RP-Coders/ArduinoWorkshop-LED-Driver/README.md

# ArduinoWorkshop-LED-Driver
Course 1 - LED Driver

This project is originally used for a course.
