RP-Coders/ArduinoWorkshop-LED-Driver/Code/Arduino workshop/README.md

# Files

Workshop 1 is the beginners example for arduino coding.

Workshop 2 is the a little more advanced

Workshop 3 is the full code for running the LED Driver - make note of the remote control values if you use something else but the Eizo remote.
