RP-Coders/ArduinoWorkshop-LED-Driver/Hardware/Eagle/5channel-LED-Relay.brd

## EAGLE design Hardware/Eagle/5channel-LED-Relay.brd (2018-10-08)

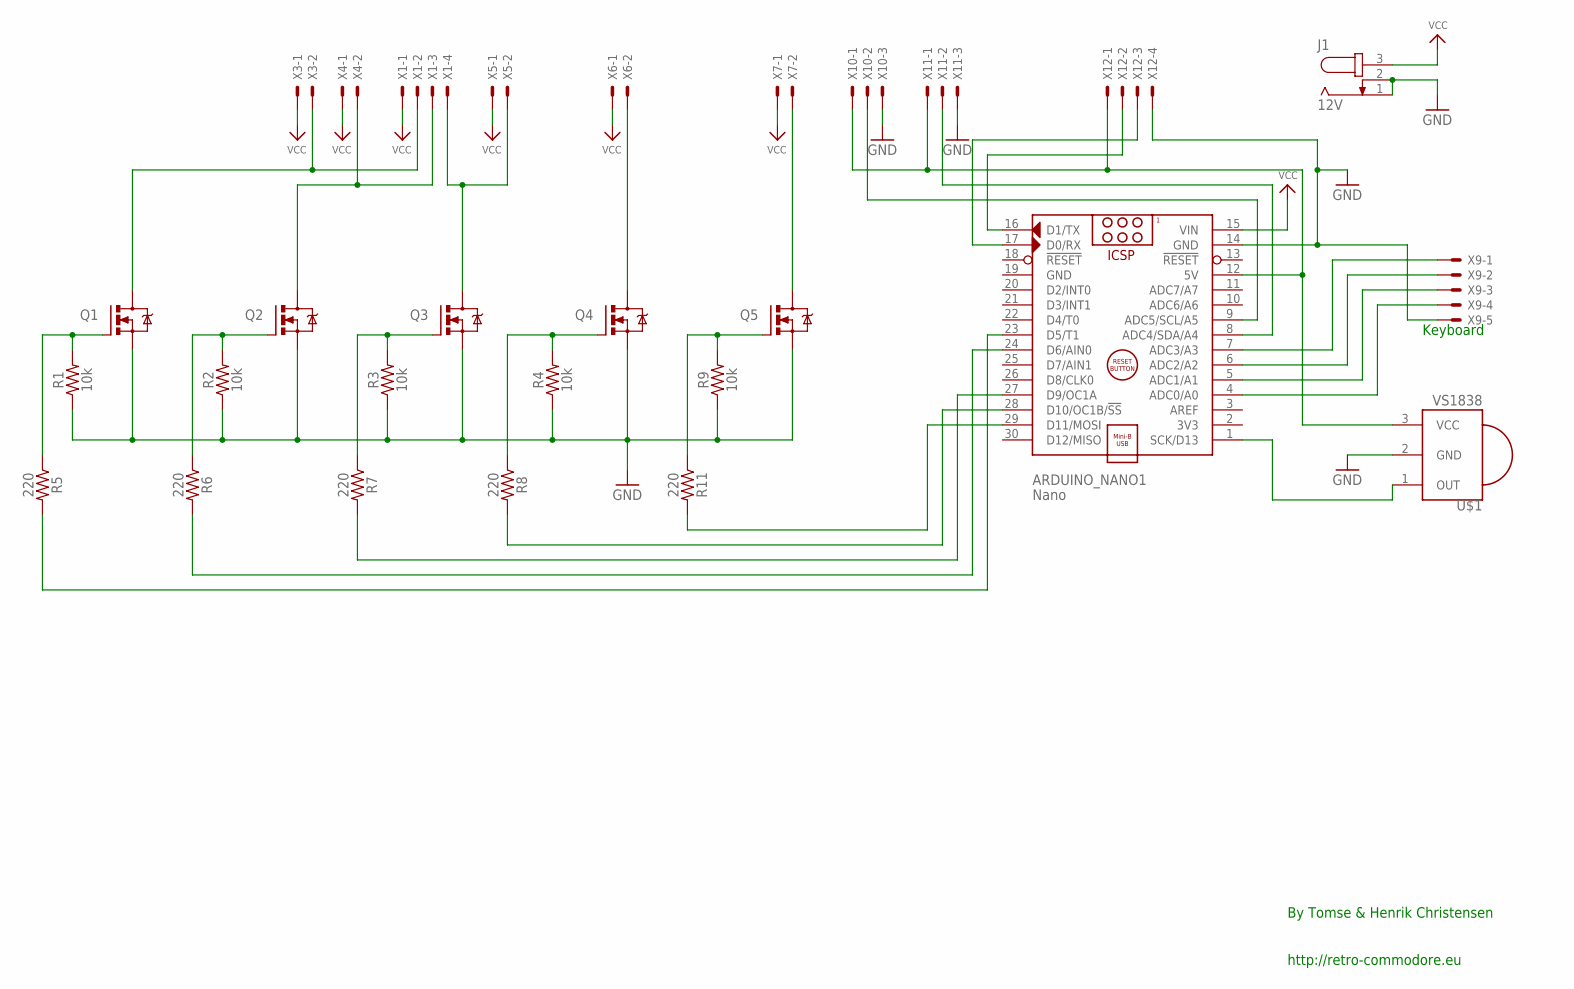
[picture p5: schematic 5channel-LED-Relay.sch]

Parts:
ARDUINO_NANO1: Nano; ARDUINO_NANO
J1: 12V; SPC4077
Q1, Q2, Q3, Q4, Q5: FQP30N06L; TO220BV
R1, R2, R3, R4, R9: 10k; AXIAL-0.3
R5, R6, R7, R8, R11: 220; AXIAL-0.3
U$1: VS1838; PNA460XM
X1, X12: JST-XH-04-PIN-LONG-PAD; JST-XH-04-PACKAGE-LONG-PAD
X3, X4, X5, X6, X7: JST-XH-02-PIN-LONG-PAD; JST-XH-02-PACKAGE-LONG-PAD
X9: JST-XH-05-PIN-LONG-PAD; JST-XH-05-PACKAGE-LONG-PAD
X10, X11: JST-XH-03-PIN-LONG-PAD; JST-XH-03-PACKAGE-LONG-PAD

Connections:
5V: ARDUINO_NANO1.12 (5V), U$1.3 (VCC), X10.1, X11.1, X12.1
C01: Q1.D, X1.2, X3.2
C02: Q2.D, X1.3, X4.2
C03: Q3.D, X1.4, X5.2
C04: Q4.D, X6.2
C05: Q5.D, X7.2
GND: ARDUINO_NANO1.14 (GND), ARDUINO_NANO1.19 (GND), J1.1, J1.2, Q1.S, Q2.S, Q3.S, Q4.S, Q5.S, R1.P$1 (1), R2.P$1 (1), R3.P$1 (1), R4.P$1 (1), R9.P$1 (1), U$1.2 (GND), X9.5, X10.3, X11.3, X12.4
unnamed: ARDUINO_NANO1.8 (ADC4/SDA/A4), X11.2
unnamed: ARDUINO_NANO1.9 (ADC5/SCL/A5), X10.2
unnamed: ARDUINO_NANO1.29 (D11/MOSI), R11.P$2 (2)
unnamed: ARDUINO_NANO1.1 (SCK/D13), U$1.1 (OUT)
unnamed: Q4.G, R4.P$2 (2), R8.P$1 (1)
unnamed: ARDUINO_NANO1.23 (D5/T1), R5.P$2 (2)
unnamed: ARDUINO_NANO1.24 (D6/AIN0), R6.P$2 (2)
unnamed: ARDUINO_NANO1.27 (D9/OC1A), R7.P$2 (2)
unnamed: ARDUINO_NANO1.28 (D10/OC1B/!SS), R8.P$2 (2)
unnamed: ARDUINO_NANO1.16 (D1/TX), X12.2
unnamed: Q2.G, R2.P$2 (2), R6.P$1 (1)
unnamed: ARDUINO_NANO1.17 (D0/RX), X12.3
unnamed: ARDUINO_NANO1.7 (ADC3/A3), X9.1
unnamed: Q5.G, R9.P$2 (2), R11.P$1 (1)
unnamed: ARDUINO_NANO1.6 (ADC2/A2), X9.2
unnamed: Q3.G, R3.P$2 (2), R7.P$1 (1)
unnamed: ARDUINO_NANO1.5 (ADC1/A1), X9.3
unnamed: ARDUINO_NANO1.4 (ADC0/A0), X9.4
unnamed: Q1.G, R1.P$2 (2), R5.P$1 (1)
VCC: ARDUINO_NANO1.15 (VIN), J1.3, X1.1, X3.1, X4.1, X5.1, X6.1, X7.1

Notes on the sheet:
Keyboard
By Tomse & Henrik Christensen http://retro-commodore.eu

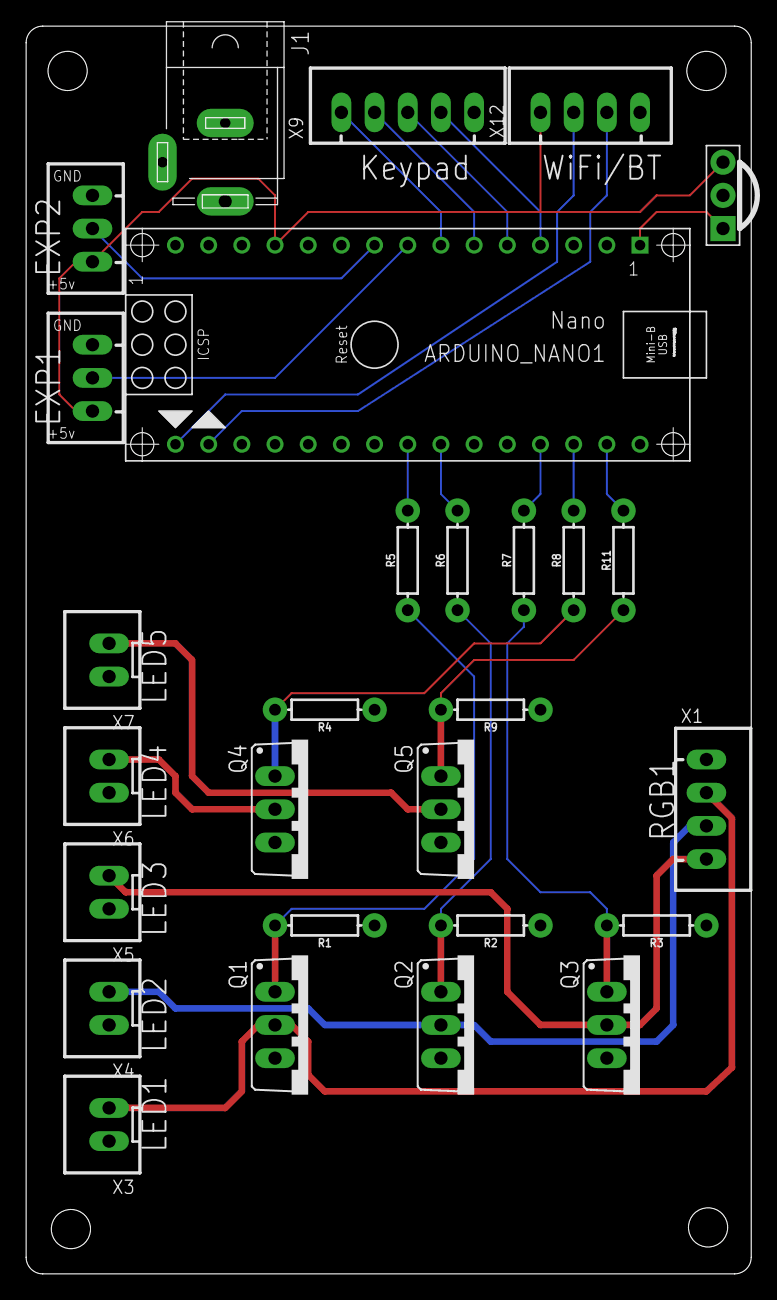
[picture p6: board 5channel-LED-Relay.brd from above]

Board: 2 copper layers, 55.5 x 95.5 mm, 28 parts (0 on the bottom side), 27 nets.
