RP-Coders/ArduinoWorkshop-LED-Driver/(commit log)

2018-10-08 Update Code/Arduino workshop/Workshop1/Workshop1.ino
    Added Course Code 1
2018-10-08 Update Code/Arduino workshop/Workshop2/Workshop2.ino
    Added Course Code 2
2018-10-08 Update Code/Arduino workshop/Workshop3/Workshop3.ino
    Added Course Code 3
2018-10-08 Update Doc/LED Driver Workshop.pdf
    Added Release Doc in pdf
2018-10-08 Update Doc/LED Driver Workshop.odt
    Added Release Doc in odt
2018-10-08 Update Hardware/Eagle/5channel-LED-Relay.brd
    Added eagle board
    [5channel-LED-Relay.brd]
2018-10-08 Update Hardware/Eagle/5channel-LED-Relay.sch
    added eagle schematic
    [5channel-LED-Relay.sch]
2018-10-08 Update Hardware/Eagle/5channel-LED-Relay_2018-07-18_cam_files.zip
    Added CAM files ready to upload to i.e. jlcpcb
2019-01-22 Working version - can power on/off single lamp
